sklarsa/thermo-feathers/(commit log)

2026-11-09 Scaffold: spec, partition table, S3 build at 80 MHz, host tests
    [partitions.csv]
2026-11-10 Milestone 1: plugged-in SHT41 logger
    Reads the SHT41 every 60 s and streams each reading to QuestDB's room_readings over QWP, via the
    qwp-embedded sender. SNTP for timestamps, device ID from the MAC's last three bytes, a day of
    readings held in RAM while QuestDB is away. Host tests for the SHT41 CRC, conversion and
    validation and for the table encoding.
2026-11-10 README: bill of materials
2026-11-10 Milestone 2: battery cycle
    Each wake reads the SHT41 into a 256-sample ring in RTC fast memory and deep-sleeps to a fixed
    60 s cadence. Every tenth wake connects, syncs SNTP and sends the ring plus a device_status row,
    popping only what QuestDB acks; failed sends back off 1x, 2x, 4x up to an hour.
    - Timestamps are frozen once from the RTC, corrected by the rate measured between syncs
    (rtc_drift_ppm); samples before the first sync carry TIME_UNSYNCED and are converted at it.
    - MAX17048 gauge: volts, %, charge rate, and the CHARGING flag. Below 10 % both intervals double;
    below 3.5 V no WiFi, and wakes every 10 minutes until charging.
    - Cold boot (power-on or RESET) stays awake 30 s: USB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
    [main.rs]
2026-11-10 Design v2: ESP-NOW nodes and a headless gateway
    WiFi is the wrong transport for the battery nodes: joining dominates the power budget, and the
    deep-sleep send path never got a second reading through. Nodes now send over ESP-NOW to one
    wall-powered gateway (the old s3-sensors Feather), which forwards to QuestDB over QWP, serves a web
    page for the room view, names, units, wake interval and node firmware updates, and replies with
    time and settings. A display and four buttons are designed as a later phase.
2026-11-11 Node enclosure: core and plain cover (stage 1), 50 mm STEMMA QT cable
    [core.scad, knobs.scad, main.scad, plain.scad, shell.scad]
2026-11-11 Enclosure: open-front core with Feather, battery and SHT41 holders; cover ribs
    Hooks and ledges as in esp-light-show, sized for PLA (1 % strain). Room at the battery's
    end for its leads. The check now covers the core as well as the cover.
    [core.scad, knobs.scad, main.scad, shell.scad]
